kakashinho/projeto-raspberrypi/hardware/etiquetas_A_B_folha_cheia.pdf

TRIG=G23 ECHO=G24 | R=G4 G=G17 B=G27

## 3V3 DAT GND

GND
| D1 RGB

BUZZER G6

J5 DHT11 G22 | SERVO1 | SERVO2
EXT 5V | RPi | R | + | G | B

VCC

TRIG

C1 100n 3 | 2 | 1 | BTN · J8 botão G5 G12 | G25 | C2 470µ 25V | G13 | G26 R5 330 | R6 1k R2 10k | R1 10k | R4 330 | R3 330

centro

Livres p/ comunicação: I2C 2,3 · UART 14,15 · SPI0 7,8,9,10,11
SPI1/I2S 16,18,19,20,21 · ID 0,1 (reservado, não usar) | centro
J4 HC-SR04 GND− J7 +5V | JP1 | 40

39

2

1 5V 3V3

5V2 GND

3

14 15 GND

18 GND

3V3 GND

10 9

8

11

# 7GND

1

0 GND GND 16

19

20 21

4 | 17 27 | GND

23

22

### 24 RASPBERRY PI (J1): números = GPIO BCM · negrito = usado nesta placa 25

5

12

6 13 | 26 SW1
5V | nc | Q1
C | B | E

ECHO

GND

Q1 BC337

S+

−

S+

−

RV1 10k | Placa de interface Raspberry Pi · etiqueta A (em cima) + B (embaixo)

B (base) - CORTE na linha tracejada e descarte esta parte.

Cole com a linha cortada encostada na etiqueta A e a outra borda na borda de baixo da placa. TRIG=G23 ECHO=G24 | R=G4 G=G17 B=G27

## 3V3 DAT GND

GND
D1 RGB

BUZZER G6

J5 DHT11 G22 | SERVO1 | SERVO2
EXT 5V | RPi | R | + | G | B

VCC

TRIG

C1 100n 3 | 2 | 1 | BTN · J8 botão G5 G12 | G25 | C2 470µ 25V | G13 | G26 R5 330 | R6 1k R2 10k | R1 10k | R4 330 | R3 330

centro

Livres p/ comunicação: I2C 2,3 · UART 14,15 · SPI0 7,8,9,10,11
SPI1/I2S 16,18,19,20,21 · ID 0,1 (reservado, não usar) | centro
J4 HC-SR04 GND− J7 +5V | JP1 | 40

39

2

1 5V 3V3

5V2 GND

3

14 15 GND

18 GND

3V3 GND

10 9

8

11

# 7GND

1

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

5

12

6 13 | 26 SW1
5V | nc | Q1
C | B | E

ECHO

GND

Q1 BC337

S+

−

S+

−

RV1 10k | Placa de interface Raspberry Pi · etiqueta A (em cima) + B (embaixo)

B (base) - CORTE na linha tracejada e descarte esta parte.

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
