kakashinho/projeto-raspberrypi/maquete/impressao/etiquetas_pimaco6282.pdf

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
A1 | A2 | A3 | A4
ENTRADA | T1 | SAÍDA | T2
1 | 2 | 3 | 4 | 5 | 6 | 7

N1 a N7: números das vagas (pretos, colam no asfalto em frente de cada vaga)

listras da cancela: ● = eixo do servo

listras da cancela: ● = eixo do servo

res.

res.

res.

res.

res.

PIMACO 6282 (folha CARTA): imprimir a 100 %. Faixas brancas: corte pelas linhas finas. Códigos = gabarito do piso.
