kakashinho/projeto-raspberrypi/maquete/impressao/gabaritos_A4.pdf

Maquete do estacionamento: gabaritos de corte | folha 1/8

Feitos para TESOURA. Papelão de 2,5 mm, escala 1:1, versão v5

## Legenda

linha de corte: o contorno da peça

recorte (sempre aberto numa borda e largo para a tesoura): corte e tire

linha de acesso: corte reto por ela, da borda até o furo (só no piso)

dobradiça: junte as 2 peças nesta quina com fita crepe (por fora e por dentro)

tira colada: guia ou trava (use a peça vizinha como espaçador)

só no piso: corte do EVA preto

referência: onde vai cada etiqueta PIMACO, parede ou peça

Como usar
1. Imprima TODAS as folhas a 100 % (tamanho real). Em cada folha, meça a régua de 100 mm.
2. Recorte o gabarito com uma sobra, prenda no papelão com fita crepe e corte por cima com a tesoura, seguindo a linha. Ou fure os cantos com um alfinete, tire o papel e ligue os pontos a lápis.
3. Não há rasgos estreitos: todo recorte começa numa borda e tem pelo menos 10 mm de largura.
Recorte largo: corte os 2 lados até o fundo e depois o fundo.
4. Peça com ×N: use o mesmo gabarito N vezes. Tiras de 5 mm: corte uma tira comprida e depois os pedaços.
5. Dobradiças: encoste as 2 peças na quina e passe fita crepe por fora e por dentro. Elas dobram planas.
6. Tiras coladas (guias e travas): cole com cola branca encostando na peça vizinha, que serve de espaçador.

## Teste antes (corte num retalho)

11,0 | 11,5 | 12,0

servo: o corpo deve entrar justo (padrão 11,5)

9,0 | 10,0 | 11,0

tubinho do pot (Ø 8,5): padrão 10

Folhas
2 e 3: piso (2 metades, emendar pelas cruzes) ꞏ 4: paredes da guarita ꞏ 5: telhado e laterais da moldura 6: frente/fundo e meio da moldura, guia da calçada ꞏ 7: carro, totem, braço, botão, batente e tiras
8: plano de corte da chapa. Etiquetas: etiquetas_pimaco6282.pdf (CARTA). Adesivos: adesivos_A4.pdf Material extra: fita crepe (dobradiças) e cola branca (tiras, EVA e carros).
0 | 50 | 100

100 mm: confira com uma régua

IMPRIMIR EM TAMANHO REAL (100 %), sem ajustar à página

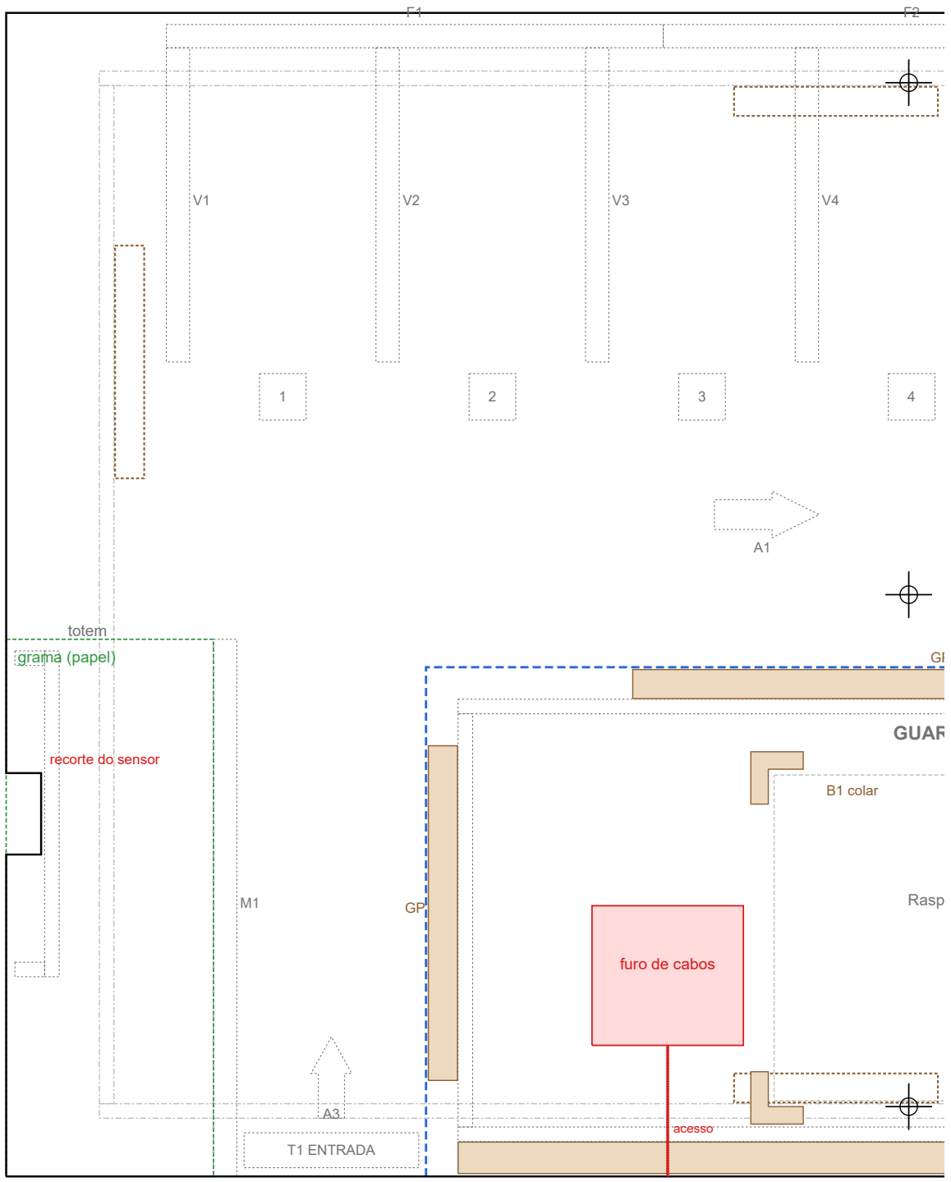
[picture p60: figure]
Raspberry Pi (entre os batentes); GUARITA: chão sem EVA; totem; grama (papel); B1 colar; GP colar (guia do fundo); T1 ENTRADA; furo de cabos; acesso; recorte do sensor

FRENTE (lado de quem opera a maquete) ↓

P1 Piso: metade esquerda | folha 2/8

Vista de cima, frente embaixo. Sobreponha as 2 folhas pelas 3 cruzes e prenda com fita.

Piso (papelão 311 × 200): sem rasgos
- Contorno: o retângulo já desenhado (281 × 200) cresce 30 mm para a direita. Recorte do sensor: aberto na borda.
- Furos (vermelho): corte reto pela linha de acesso (tracejada), da borda da frente até o furo, e recorte o furo. Depois passe fita crepe por baixo da linha de acesso. A tira da calçada, colada por cima, também fecha o corte.
- EVA preto: mesmo molde. Contorno, recorte da guarita (azul) e recorte do sensor. Cole com cola branca.
- Tiras: GP e B1 colam em cima; TP (tracejado marrom) colam por baixo. Etiquetas: códigos em cinza.

P1 Piso: metade direita | folha 3/8

Vista de cima, frente embaixo. Sobreponha as 2 folhas pelas 3 cruzes e prenda com fita.

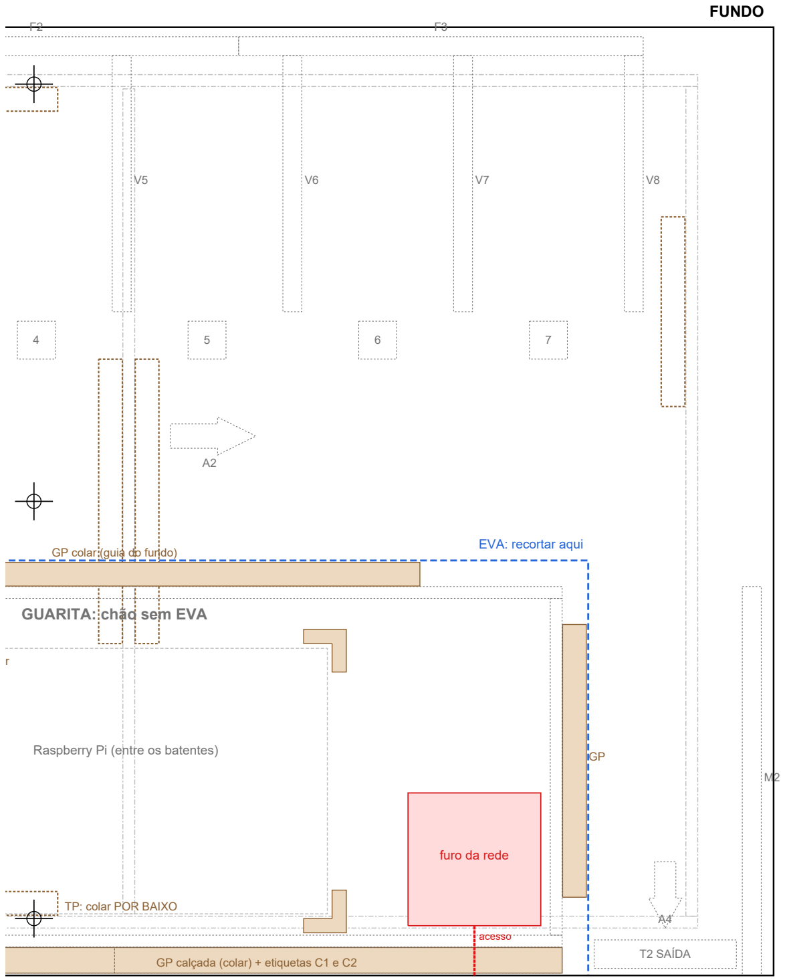
[picture p61: figure]
TP: colar POR BAIXO; Raspberry Pi (entre os batentes); GUARITA: chão sem EVA; B1 colar; GP colar (guia do fundo); T2 SAÍDA; GP calçada (colar) + etiquetas C1 e C2; EVA: recortar aqui; furo da rede; acesso; FUNDO

Piso (papelão 311 × 200): sem rasgos
- Contorno: o retângulo já desenhado (281 × 200) cresce 30 mm para a direita. Recorte do sensor: aberto na borda.
- Furos (vermelho): corte reto pela linha de acesso (tracejada), da borda da frente até o furo, e recorte o furo. Depois passe fita crepe por baixo da linha de acesso. A tira da calçada, colada por cima, também fecha o corte.
- EVA preto: mesmo molde. Contorno, recorte da guarita (azul) e recorte do sensor. Cole com cola branca.
- Tiras: GP e B1 colam em cima; TP (tracejado marrom) colam por baixo. Etiquetas: códigos em cinza.

Guarita: paredes | folha 4/8

Fundo + 2 laterais com dobradiças de fita (dobram planas). O painel fica solto.

## G1 Painel (parede da frente) ×1

vista de FORA (você de frente para o painel) ↑ em cima

tubinho

LED

energia

fita | fita

## G2 Parede do fundo ×1

recortes de baixo: servos (em pé, eixo para fora) dobradiças (verde) nas 2 pontas, com as laterais G3 ↑ em cima

fita

### G3 Parede lateral ×2

↑ em cima
← frente | fundo (fita) →

Montagem da guarita
1. Junte G2 com as 2 G3 pelas quinas de trás (fita crepe por fora e por dentro): vira um U.
2. Ponha os servos em pé no piso, no lugar; desça o U por cima: os servos entram pelos recortes de baixo do fundo.
3. O U fica entre as guias GP coladas no piso.
4. Pi + placa entre os batentes.
5. Painel G1: atrás da tira da calçada, encostado na frente das laterais. O botão do pot, por fora, segura ele em pé.
6. Telhado por cima (travas GT por dentro). Para tirar o painel: puxe o botão, incline para a frente e levante.

Telhado e laterais da moldura | folha 5/8

Telhado visto de cima (frente embaixo); as travas GT colam por baixo.

## G4 Telhado ×1

vista de cima, FRENTE embaixo ↓ tracejado marrom: travas GT (colar POR BAIXO)

Telhado
Retângulo liso. As 3 travas GT colam embaixo, por dentro das laterais e do fundo:
o telhado encaixa no U e não escorrega. O painel da frente sai sem tirar o telhado.

Moldura (estrutura de 5 cm) 4 painéis com dobradiças nos cantos (o 4º canto fecha com fita na montagem). Os vãos embaixo são para os cabos.

fita | fita

## ES Moldura: lateral ×2

↑ em cima (encosta no piso)
o vão é a passagem do cabo do sensor

Moldura: frente/fundo e painel do meio | folha 6/8

A frente e o fundo são iguais (×2). O painel do meio fica solto, entre 2 travas TP coladas embaixo do piso.

fita | fita

## EF Moldura: frente e fundo ×2

↑ em cima
o vão é a passagem do cabo de rede

## EM Moldura: painel do meio ×1

↑ em cima
solto; fica de pé entre as travas TP do meio

Montagem da moldura
1. Junte EF, ES, EF, ES com fita nas quinas (por fora e por dentro), formando um anel.
2. Feche a última quina com um pedaço de fita.
3. Ponha o painel do meio EM em pé.
4. Desça o piso: as travas TP de baixo encaixam por dentro da moldura e dos dois lados do EM.
Para guardar: tire a fita da última quina e dobre a moldura em ziguezague.

GP guia da calçada ×1 (188,8 × 5,4): cola na frente da guarita, encostada no painel; as etiquetas C1 e C2 vão em cima

Peças pequenas e tiras | folha 7/8

Carro (caixinha colada), totem do sensor, braço da cancela, botão do pot, batente do Pi e as tiras de 5 mm.

CL ×16
Carro: lateral
2 por carro

CF ×16
Carro: frente/traseira
2 por carro | CT ×8
| Carro: teto
| 1 por carro

S1 ×1
Totem: frente
↑ em cima
janelas = sensor

S2 ×2
Totem: lado
fita na quina
com S1

C1 ×2
Braço da cancela
- = eixo do servo | K1 ×1
| Botão do pot

B1 ×4
Batente do Pi
colar no piso

### Tiras de 5 mm (cola branca)

GP ×1 guia do fundo (128,8 × 5,0)

GP ×2 guia lateral (57,5 × 5,0)

GT ×1 trava do fundo (143,8 × 5,0)

GT ×2 trava lateral (51,0 × 5,0)

TP ×2 trava do meio (60,0 × 5,0)

TP ×2 trava lateral (40,0 × 5,0)

TP ×2 trava frente/fundo (35,0 × 5,0)

Carro (8): caixinha colada
1. Cole os adesivos nas peças.
2. Teto CT virado para baixo; cole as
2 laterais CL em pé nas bordas compridas e a frente/traseira CF entre elas.
Totem: S1 + 2 S2 com fita nas quinas;
o sensor fica dentro, pinos no recorte.

Plano de corte da chapa de papelão (1 m × 1 m), escala 1:6 | folha 8/8

Sugestão de onde tirar cada peça. Deixe ~4 mm entre as peças.

P1

G4 | G2 | G3 | G3
G1 | EF | EF | ES
ES | EM
S1 | CT

CT

CT | CT | CT | CT | CT | CT | CL | CL | CL | CL | CL | CL
CL | CL | CL | CL | CL | CL | CL | CL | CL | CL

## Lista de peças de papelão

Código Peça | Qtd | Medida
P1 | Piso | ×1 | 311,0 × 200,0 mm
EF | Moldura: frente e fundo | ×2 | 279,0 × 47,5 mm
ES | Moldura: lateral | ×2 | 175,0 × 47,5 mm
EM | Moldura: painel do meio | ×1 | 174,0 × 47,5 mm
G1 | Painel (parede da frente) | ×1 | 188,8 × 61,5 mm
G2 | Parede do fundo | ×1 | 188,8 × 62,0 mm
G3 | Parede lateral | ×2 | 71,0 × 62,0 mm
G4 | Telhado | ×1 | 194,8 × 82,0 mm
S1 | Totem: frente | ×1 | 56,0 × 26,0 mm
S2 | Totem: lado | ×2 | 5,1 × 26,0 mm
C1 | Braço da cancela | ×2 | 55,1 × 8,0 mm
K1 | Botão do pot | ×1 | 16,0 × 16,0 mm
B1 | Batente do Pi | ×4 | 9,0 × 9,0 mm
CL | Carro: lateral | ×16 | 50,0 × 15,0 mm
CF | Carro: frente/traseira | ×16 | 19,0 × 15,0 mm
CT | Carro: teto | ×8 | 24,0 × 50,0 mm
+ tiras de 5 mm: GP ×4, TP ×6, GT ×3 (comprimentos nas folhas 6 e 7)
