kakashinho/projeto-raspberrypi/codigo/exemplos_originais/LEIA-ME.md

# Exemplos originais

Os 9 scripts do começo do projeto, sem alterações. Só `rgb_pwm_interativo.py` e `calibracao_pot2.py` estão de acordo com a placa final. Os outros usam pinos da montagem antiga ou têm TRIG e ECHO trocados. A tabela de ajustes está no guia, seção "Códigos de teste (antigo)".
