kakashinho/projeto-raspberrypi/hardware/previas/etiqueta_A_pimaco.png

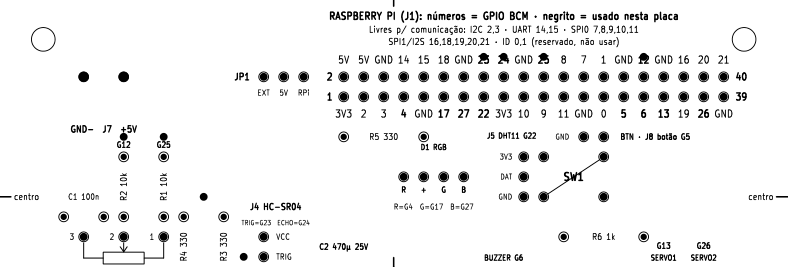
hardware/previas/etiqueta_A_pimaco.png
