kakashinho/projeto-raspberrypi/hardware/previas/placa_topo_adesivo.png

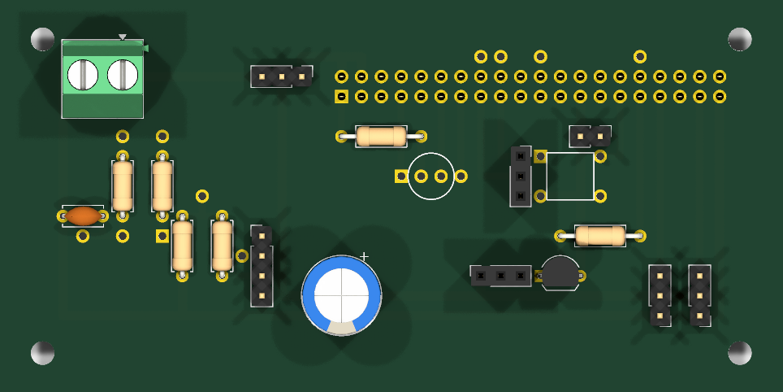
hardware/previas/placa_topo_adesivo.png
