kakashinho/projeto-raspberrypi/hardware/previas/previa_etiqueta.png

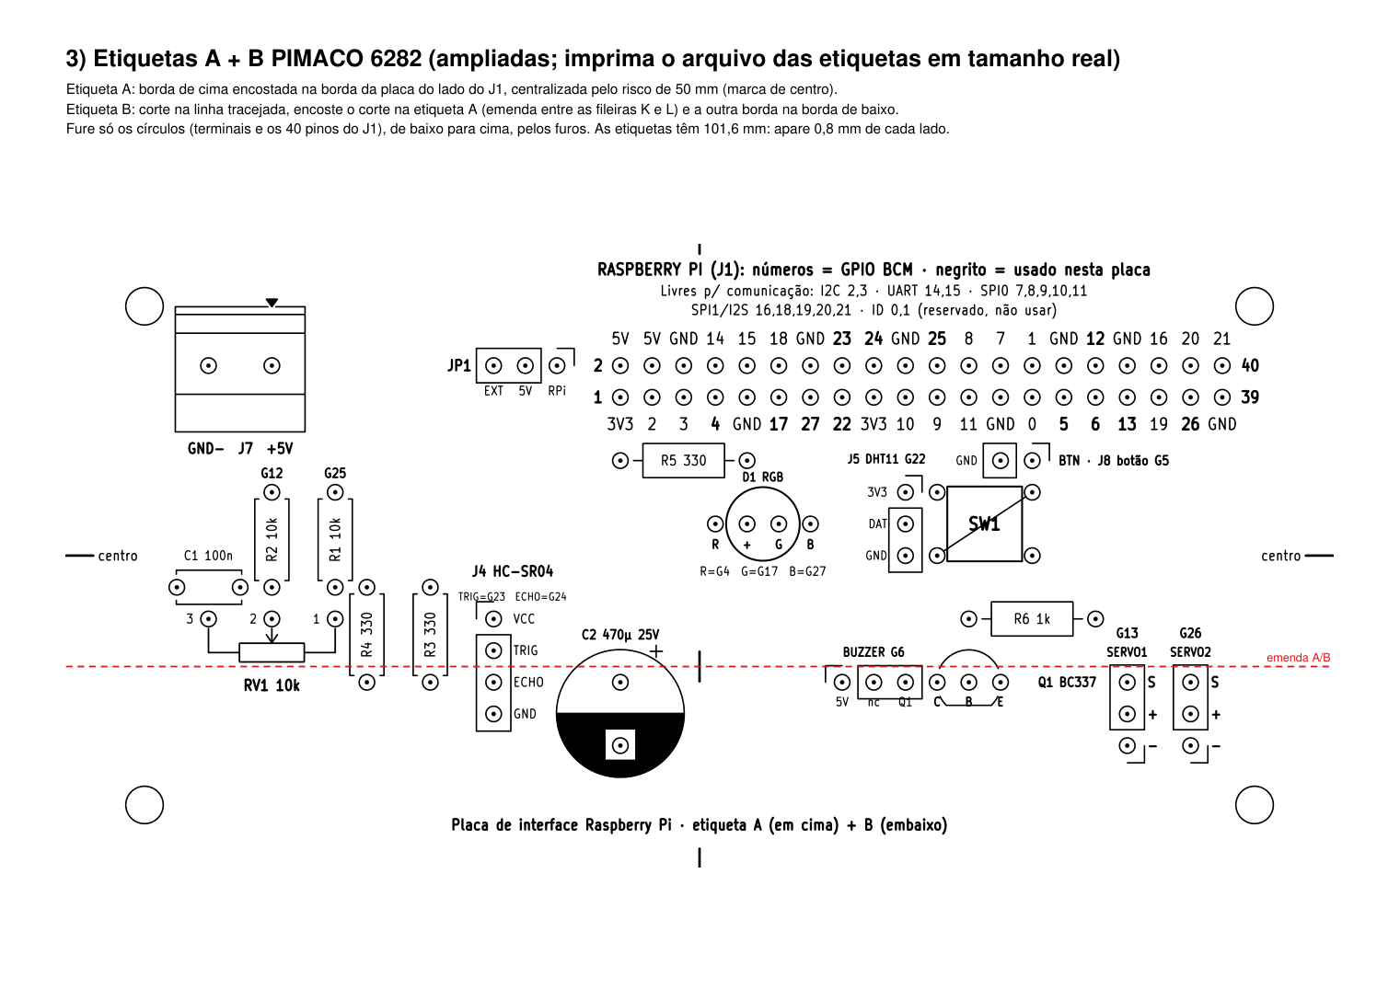
hardware/previas/previa_etiqueta.png
