kakashinho/projeto-raspberrypi/hardware/previas/previa_folha.png

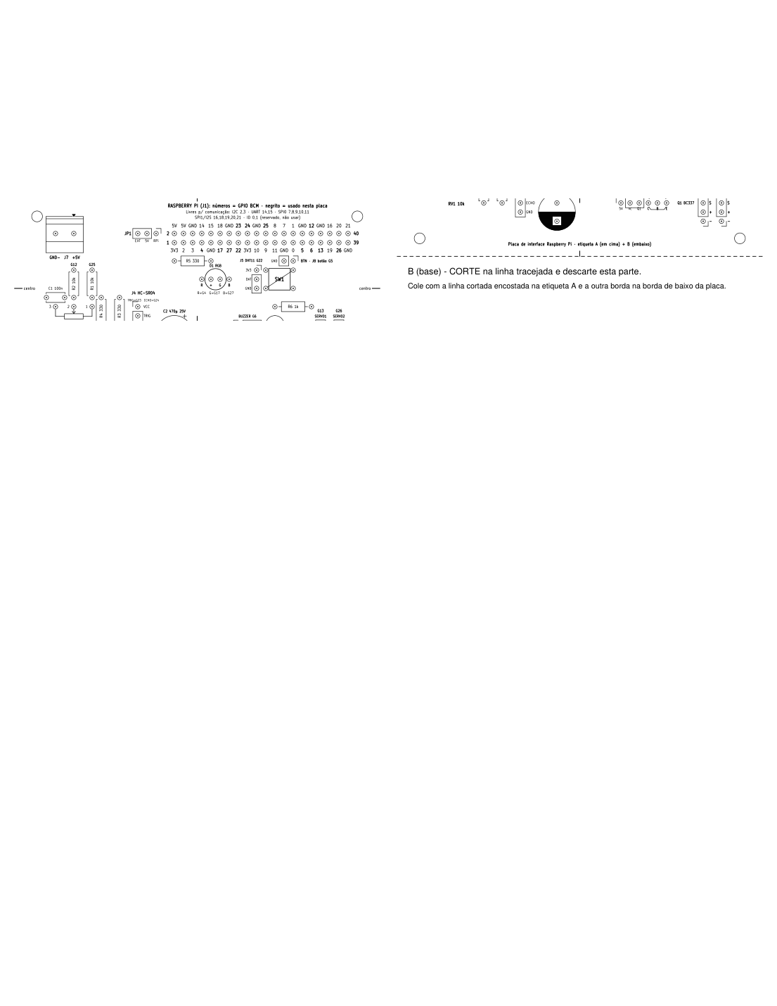
hardware/previas/previa_folha.png
