kakashinho/projeto-raspberrypi/hardware/previas/previa_lista.png

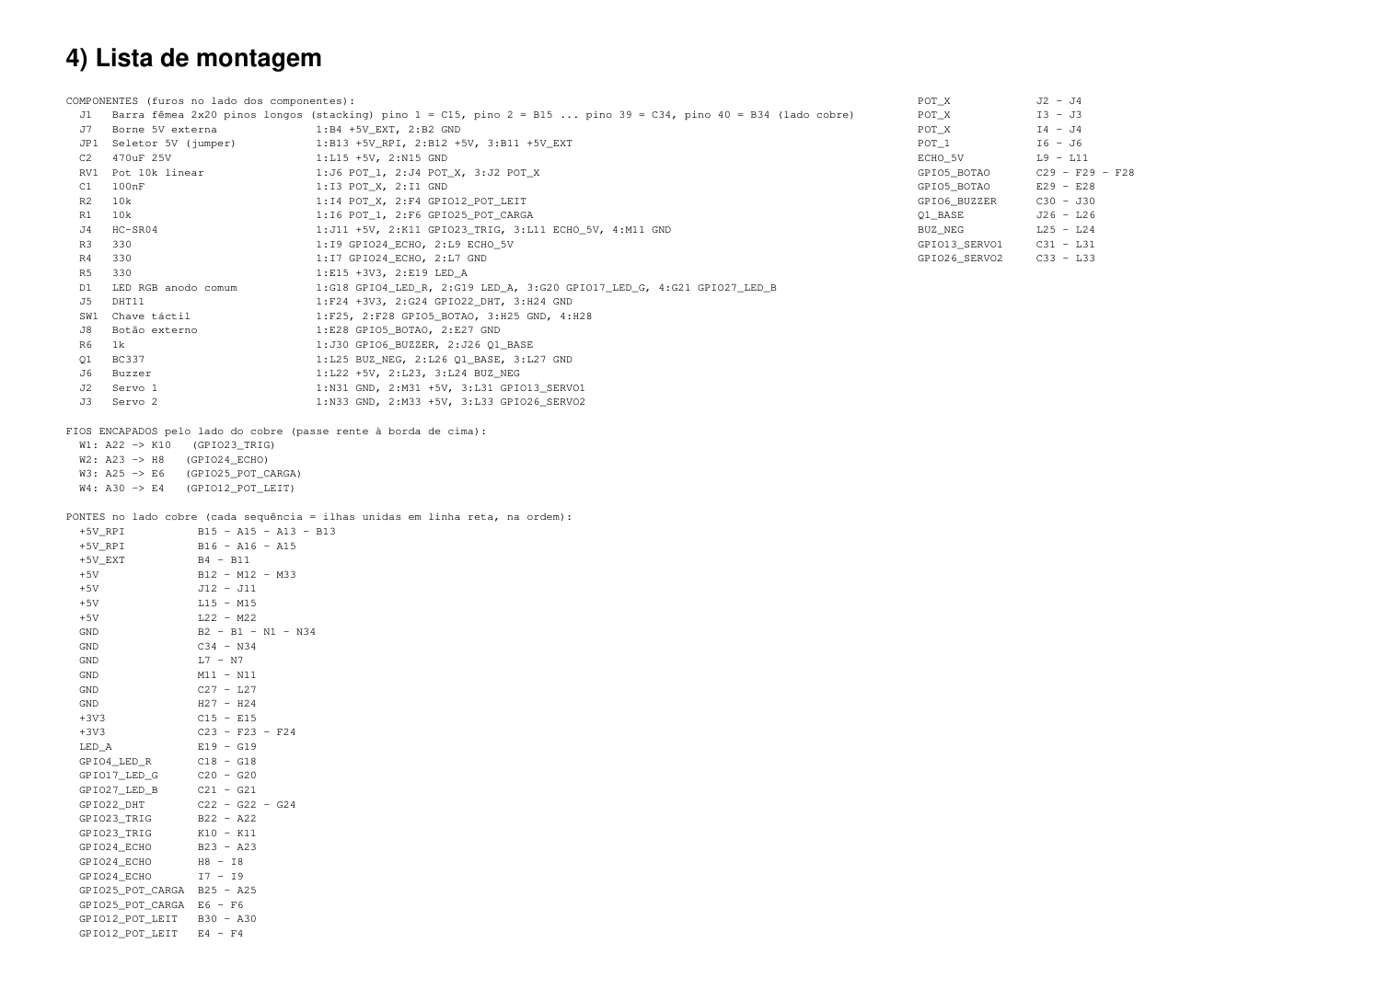
hardware/previas/previa_lista.png
