kakashinho/projeto-raspberrypi/hardware/previas/previa_trilhas.png

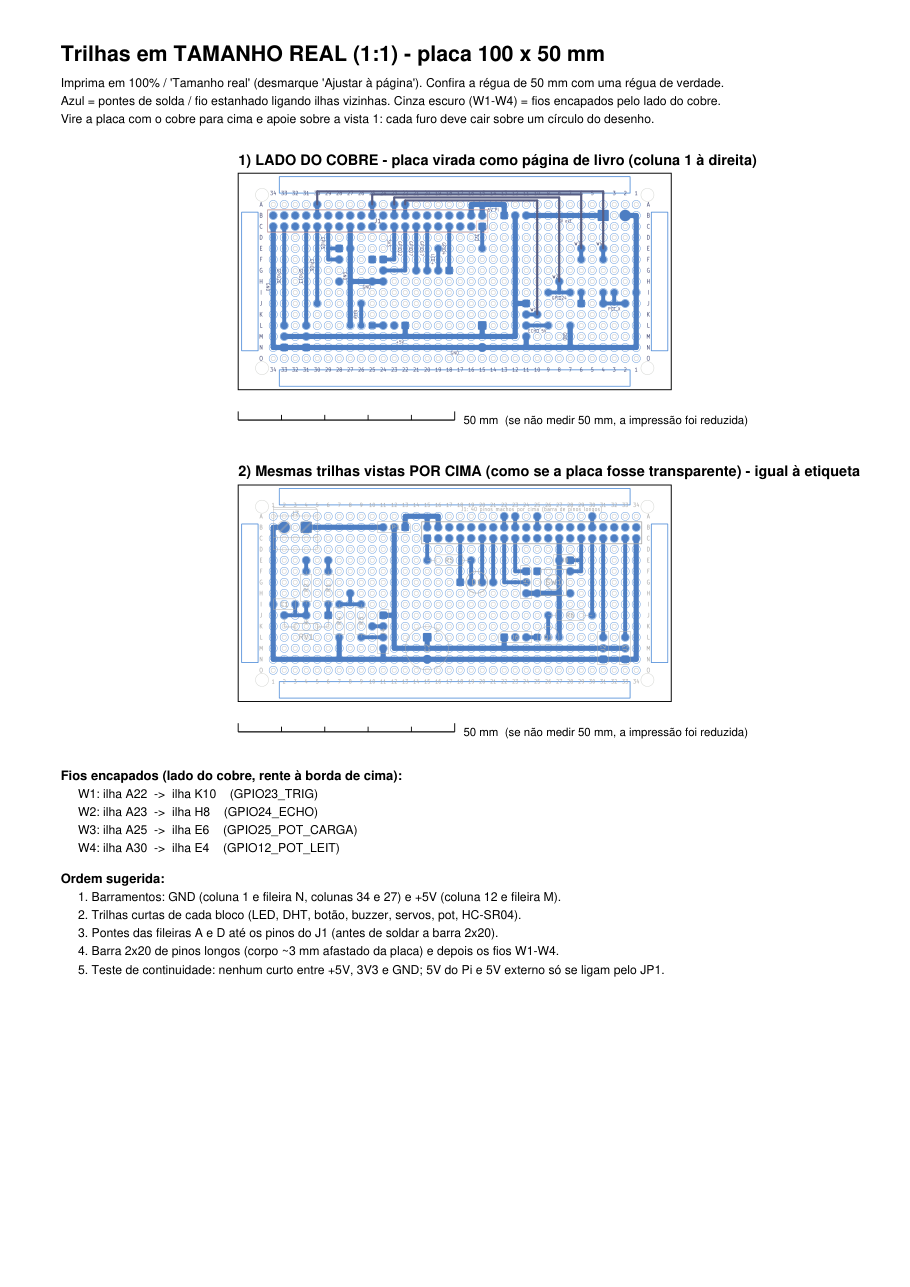
hardware/previas/previa_trilhas.png
