kakashinho/projeto-raspberrypi/maquete/previas/planta_v5.png

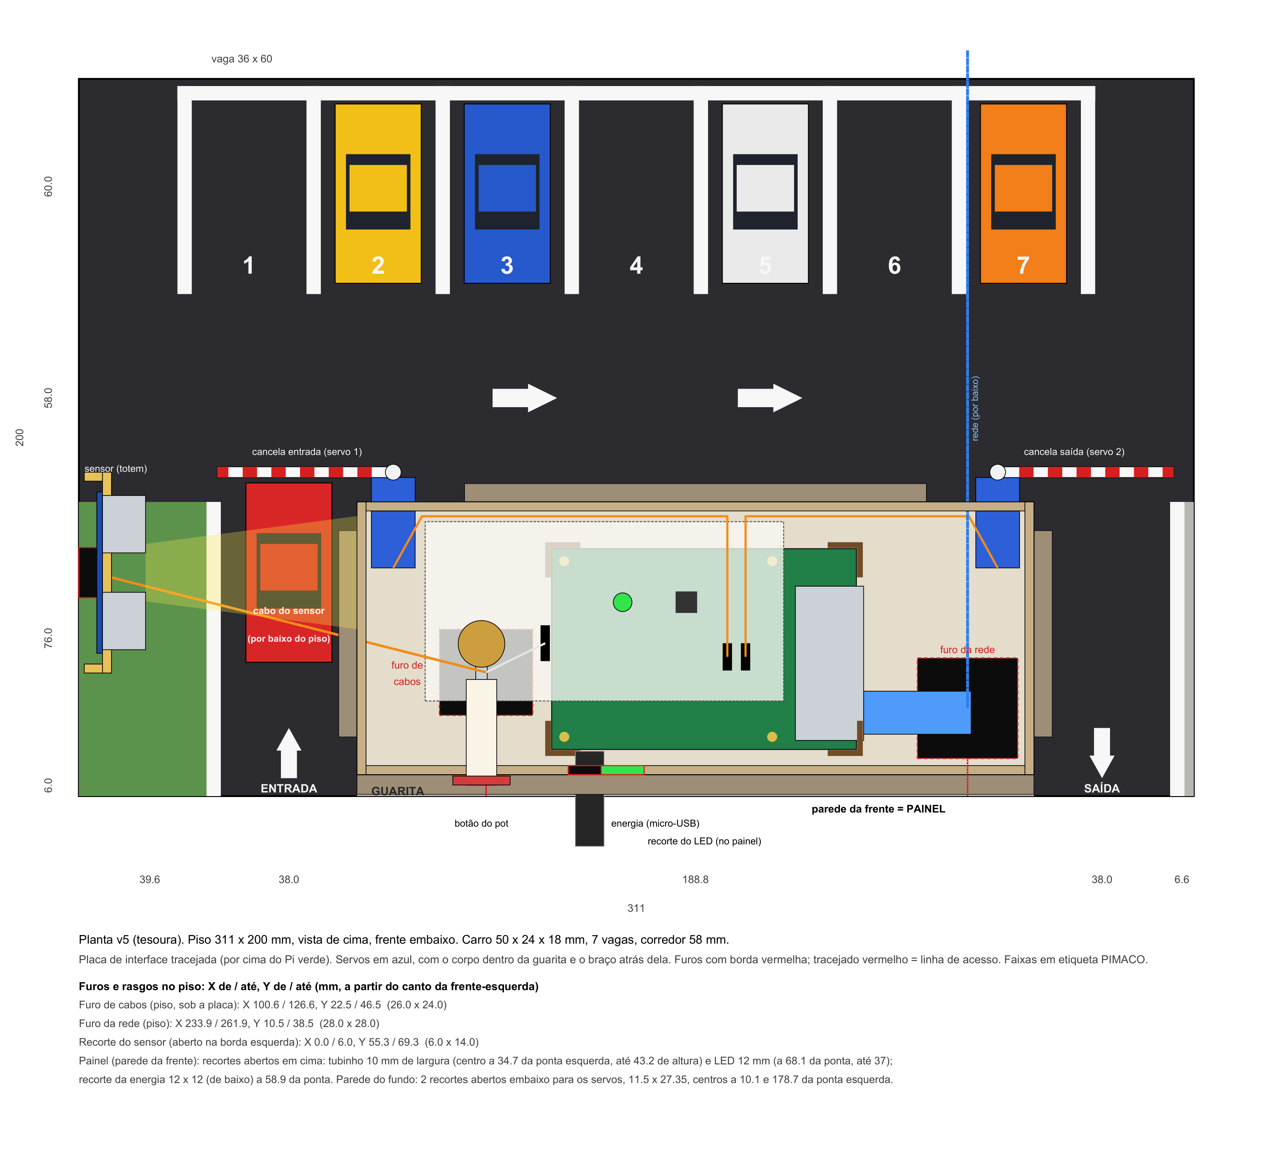
maquete/previas/planta_v5.png
