kakashinho/projeto-raspberrypi/hardware/previas/previa_montagem_p1.png

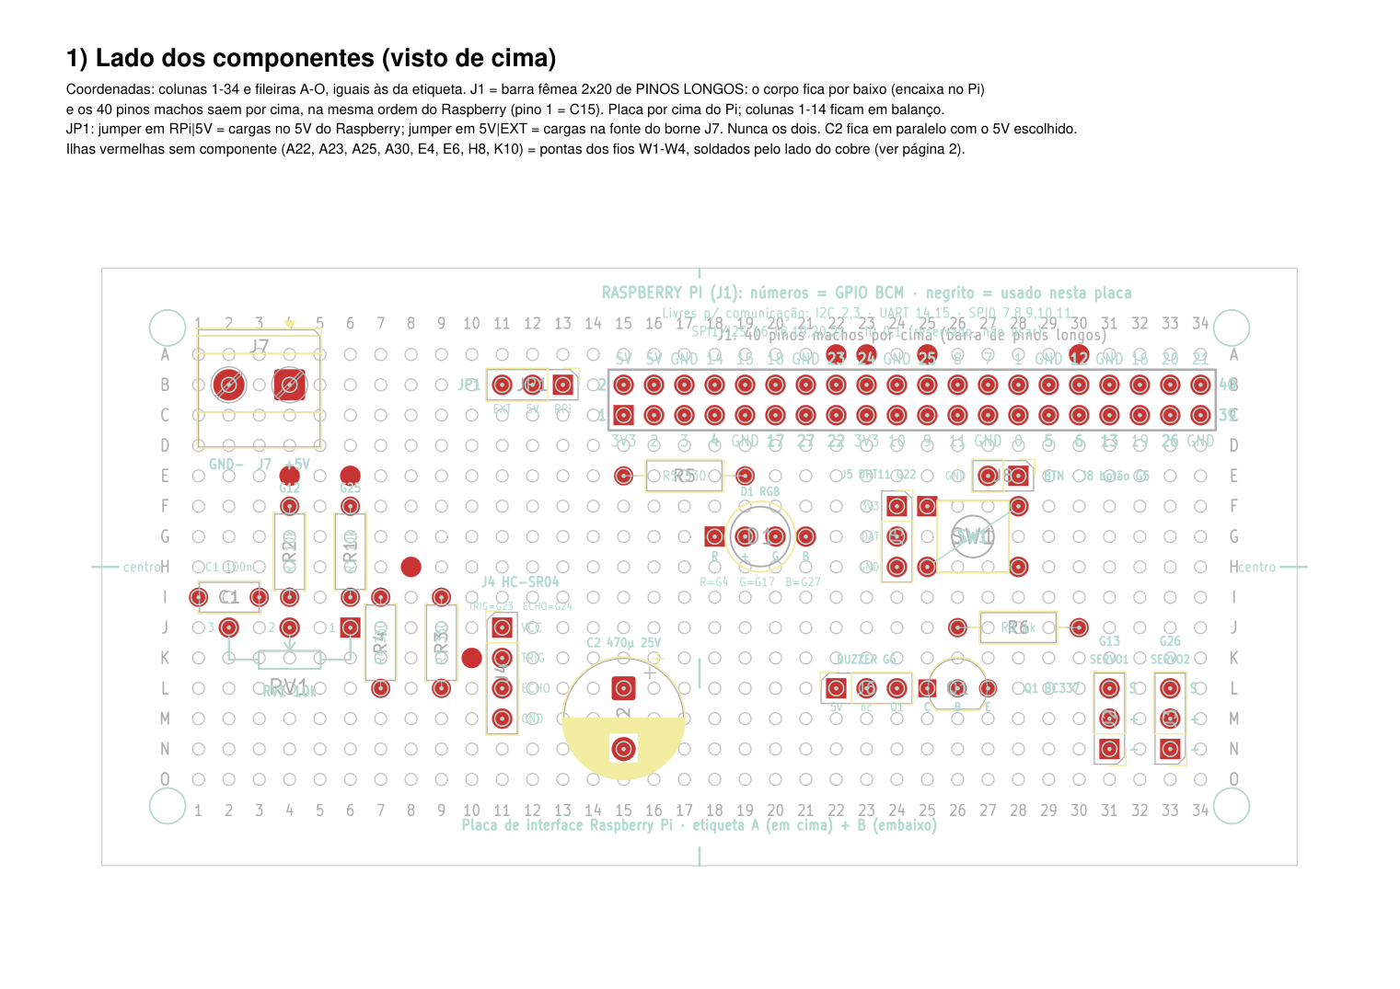
hardware/previas/previa_montagem_p1.png
