kakashinho/projeto-raspberrypi/hardware/previas/previa_montagem_p2.png

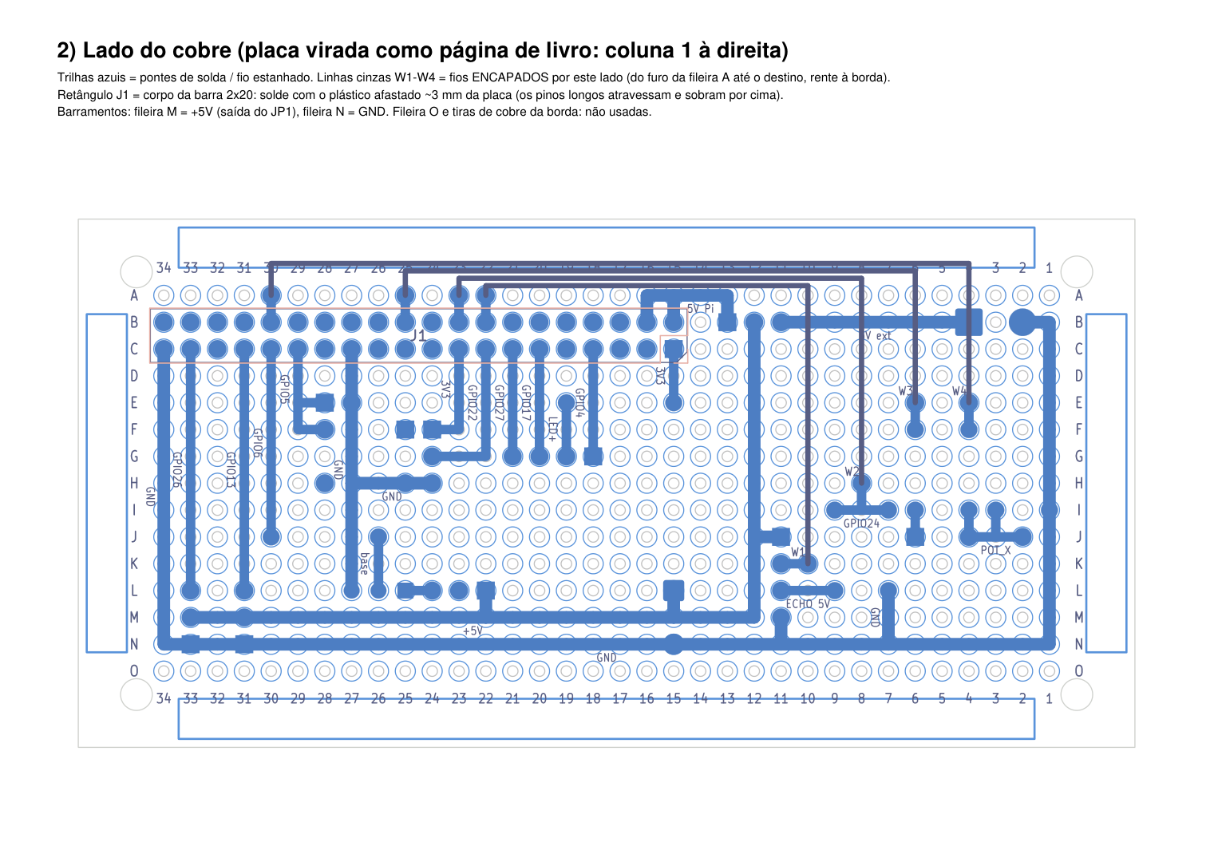
hardware/previas/previa_montagem_p2.png
