kakashinho/projeto-raspberrypi/maquete/impressao/etiquetas_pimaco6282_teste.pdf

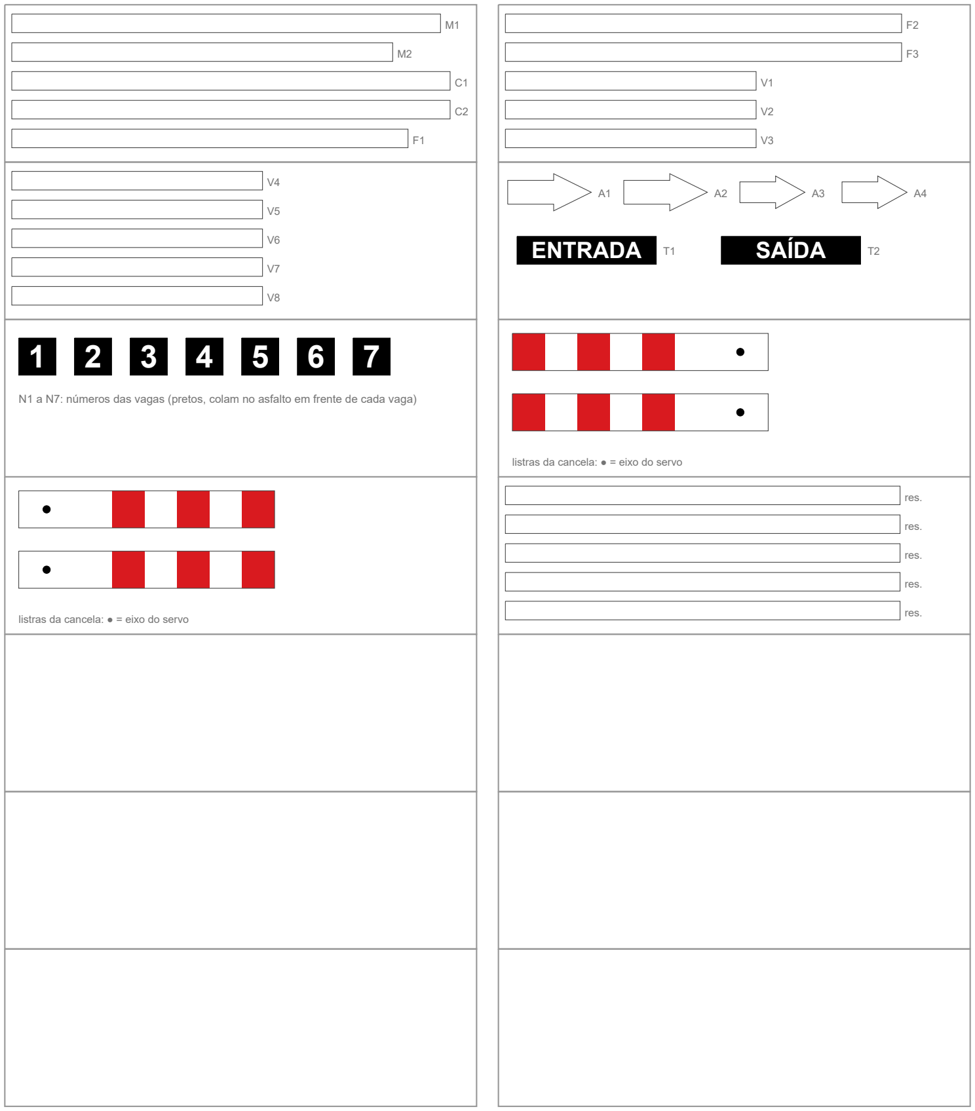
[picture p73: figure]
ENTRADA; SAÍDA; listras da cancela: ● = eixo do servo; res.

N1 a N7: números das vagas (pretos, colam no asfalto em frente de cada vaga)

TESTE em papel comum: imprima a 100 % (papel CARTA), ponha sobre a folha PIMACO 6282 contra a luz e confira.
