kakashinho/projeto-raspberrypi/hardware/etiquetas_teste_papel_comum.pdf

1 5V 3V3

# 7GND

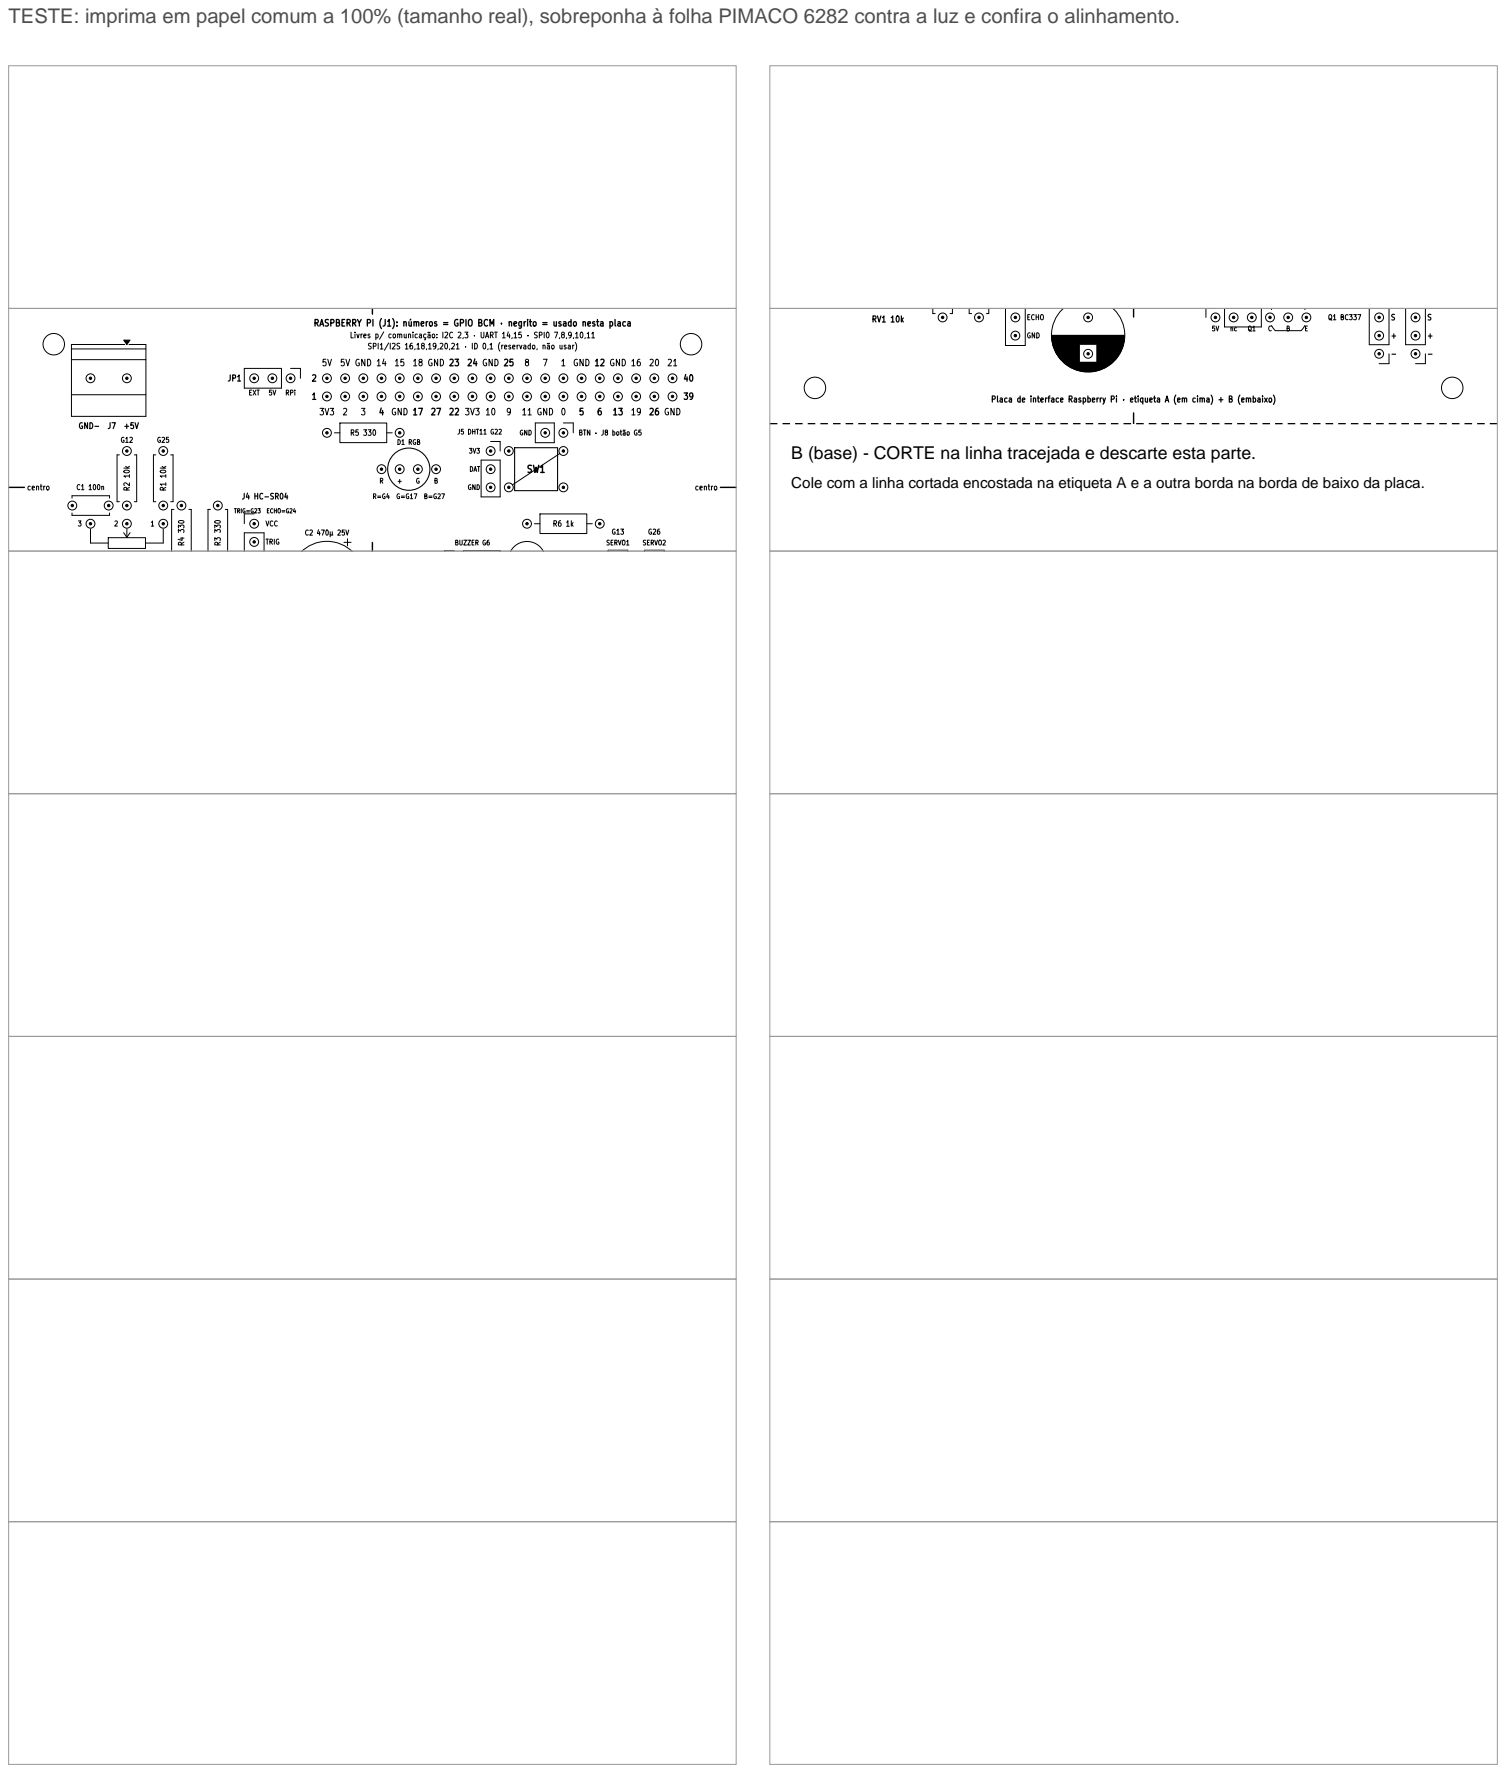
[picture p74: page 1]

TESTE: imprima em papel comum a 100% (tamanho real), sobreponha à folha PIMACO 6282 contra a luz e confira o alinhamento.

24 RASPBERRY PI (J1): números = GPIO BCM · negrito = usado nesta placa 25

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
