kakashinho/projeto-raspberrypi/maquete/impressao/adesivos_A4.pdf

Adesivos da guarita | adesivos 1/3

Imprima colorido, recorte pela linha fina e cole com cola bastão. Tracejado vermelho = recortar fora.

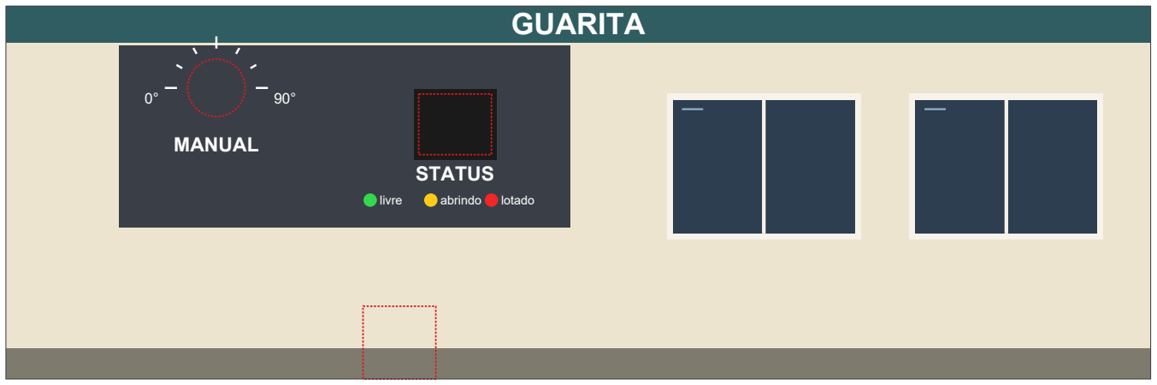
[picture p75: figure]
GUARITA; MANUAL; STATUS; livre; abrindo; lotado

### G1 painel: cole na face de FORA. O papel cobre os recortes de cima; recorte o círculo e a

janela do LED (dobre o papel no meio deles e corte) e o recorte de baixo.

# ESTACIONAMENTO

G2 fundo: cole na face de FORA (lado das cancelas); corte os 2 recortes de baixo (servos).

G3 lateral (porta) | G3 lateral (janela)

# SENSOR

### S1 totem: faixa de cima (acima das janelas)

| K1 botão
0 | 50 | 100

## 100 mm: confira com uma régua

## IMPRIMIR EM TAMANHO REAL (100 %), sem ajustar à página

Adesivos: telhado e grama | adesivos 2/3

Telhado e grama vistos de cima, com a frente embaixo.

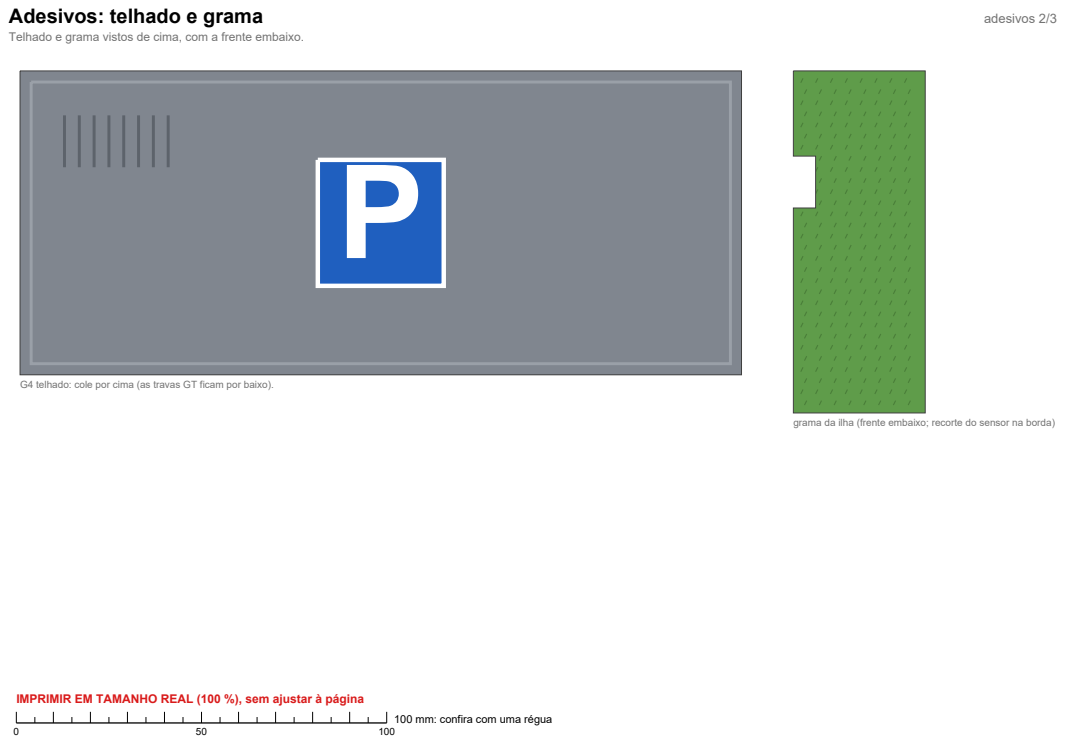
[picture p76: page 2]

G4 telhado: cole por cima (as travas GT ficam por baixo).

grama da ilha (frente embaixo; recorte do sensor na borda)

Adesivos dos carros (8) | adesivos 3/3

Teto, 2 laterais, frente e traseira de cada carro. Cole com cola bastão em cada peça ANTES de montar.

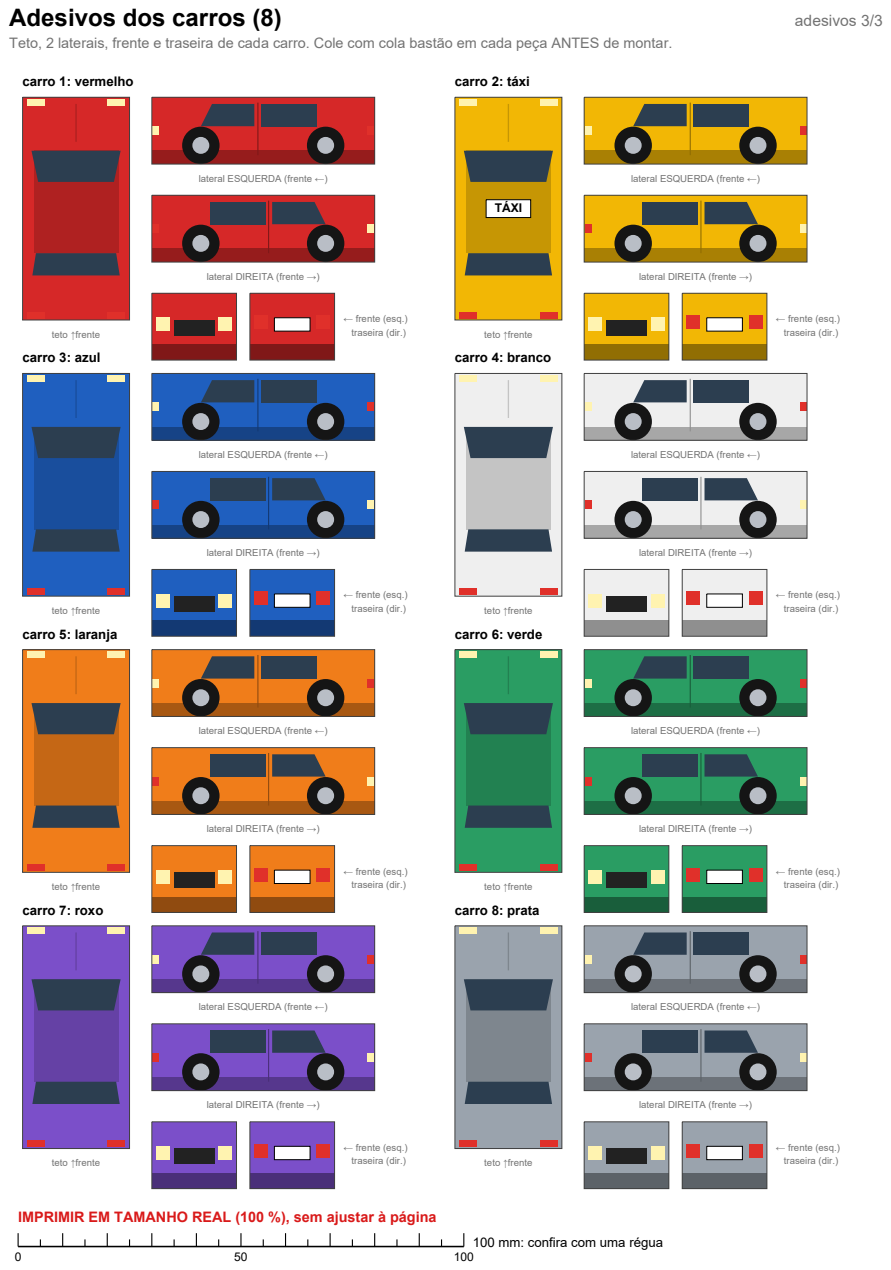
[picture p77: page 3]
carro 1: vermelho; teto ↑frente; ← frente (esq.) traseira (dir.); carro 2: táxi; TÁXI; carro 3: azul; carro 4: branco; carro 5: laranja; carro 6: verde; carro 7: roxo; carro 8: prata

lateral ESQUERDA (frente ←)

lateral DIREITA (frente →)
