kakashinho/projeto-raspberrypi/hardware/placa_interface.kicad_pcb

## KiCad design hardware/placa_interface.kicad_pcb (2026-11-08)

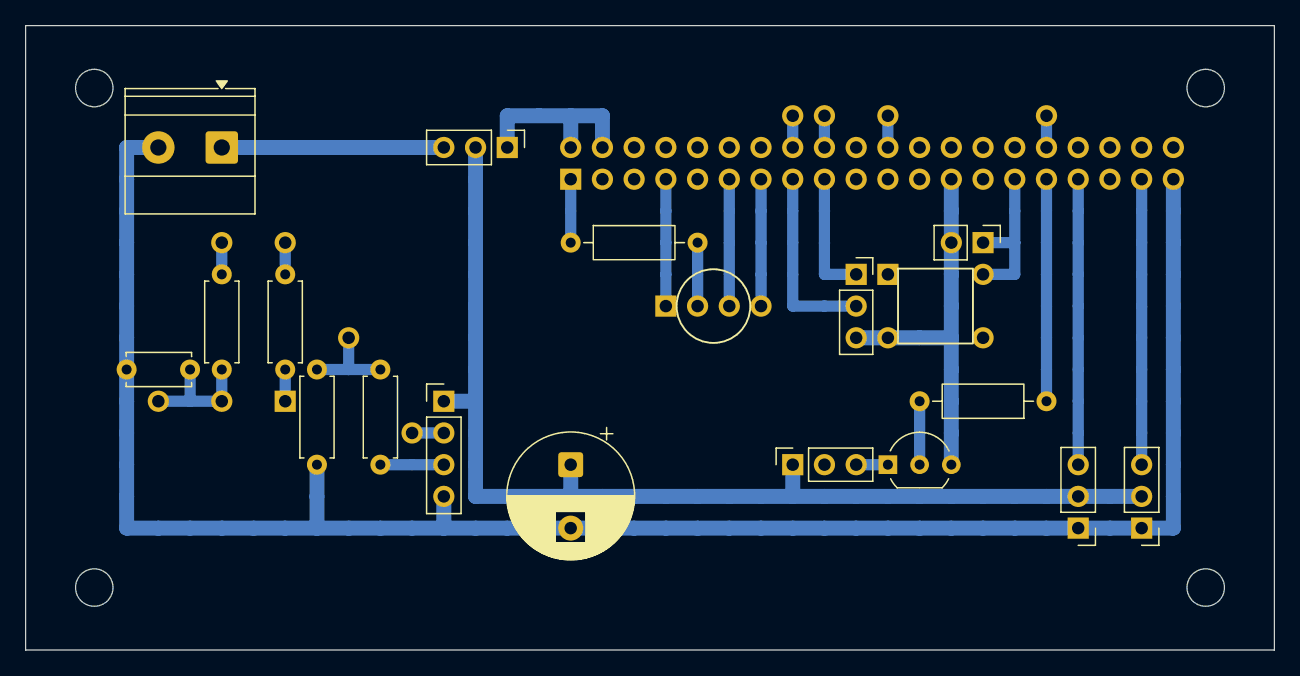
[picture p78: board placa_interface.kicad_pcb from above]

Board: 2 copper layers, 100.0 x 50.0 mm, 25 parts (1 on the bottom side), 23 nets.

Parts:
C1: 100nF; C_Disc_D5.0mm_W2.5mm_P5.00mm
C2: 470uF 25V; CP_Radial_D10.0mm_P5.00mm
D1: LED RGB anodo comum
J1: Barra fêmea 2x20 pinos longos (stacking); PinSocket_2x20_P2.54mm_Vertical
J2: Servo 1; PinHeader_1x03_P2.54mm_Vertical
J3: Servo 2; PinHeader_1x03_P2.54mm_Vertical
J4: HC-SR04; PinHeader_1x04_P2.54mm_Vertical
J5: DHT11; PinSocket_1x03_P2.54mm_Vertical
J6: Buzzer; PinSocket_1x03_P2.54mm_Vertical
J7: Borne 5V externa; TerminalBlock_Phoenix_MKDS-1,5-2-5.08_1x02_P5.08mm_Horizont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
J8: Botão externo; PinHeader_1x02_P2.54mm_Vertical
JP1: Seletor 5V (jumper); PinHeader_1x03_P2.54mm_Vertical
Q1: BC337; TO-92_Inline_Wide
R1, R2: 10k; R_Axial_DIN0207_L6.3mm_D2.5mm_P7.62mm_Horizontal
R3, R4: 330; R_Axial_DIN0207_L6.3mm_D2.5mm_P7.62mm_Horizontal
R5: 330; R_Axial_DIN0207_L6.3mm_D2.5mm_P10.16mm_Horizontal
R6: 1k; R_Axial_DIN0207_L6.3mm_D2.5mm_P10.16mm_Horizontal
RV1: Pot 10k linear
SW1: Chave táctil
W1, W2, W3, W4: fio encapado (lado cobre)

Connections:
+3V3: J1.1, J1.17, J5.1, R5.1
+5V: C2.1, J2.2, J3.2, J4.1, J6.1, JP1.2
+5V_EXT: J7.1, JP1.3
+5V_RPI: J1.2, J1.4, JP1.1
BUZ_NEG: J6.3, Q1.1
ECHO_5V: J4.3, R3.2
GND: C1.2, C2.2, J1.6, J1.9, J1.14, J1.20, J1.25, J1.30, J1.34, J1.39, J2.1, J3.1, J4.4, J5.3, J7.2, J8.2, Q1.3, R4.2, SW1.3
GPIO4_LED_R: D1.1, J1.7
GPIO5_BOTAO: J1.29, J8.1, SW1.2
GPIO6_BUZZER: J1.31, R6.1
GPIO12_POT_LEIT: J1.32, R2.2, W4.1
GPIO13_SERVO1: J1.33, J2.3
GPIO17_LED_G: D1.3, J1.11
GPIO22_DHT: J1.15, J5.2
GPIO23_TRIG: J1.16, J4.2, W1.1
GPIO24_ECHO: J1.18, R3.1, R4.1, W2.1
GPIO25_POT_CARGA: J1.22, R1.2, W3.1
GPIO26_SERVO2: J1.37, J3.3
GPIO27_LED_B: D1.4, J1.13
LED_A: D1.2, R5.2
POT_1: R1.1, RV1.1
POT_X: C1.1, R2.1, RV1.2, RV1.3
Q1_BASE: Q1.2, R6.2
