kakashinho/projeto-raspberrypi/codigo/sistema/pinos.py

SERVO_ENTRADA = 13
SERVO_SAIDA = 26

US_TRIG = 23
US_ECHO = 24

LED_R, LED_G, LED_B = 4, 17, 27

BUZZER = 6
BOTAO = 5

POT_CARGA = 12
POT_LE = 25

DHT11 = 22
