kakashinho/projeto-raspberrypi/codigo/starter/tarefa5_teste_dht11.py

import time
import board
import adafruit_dht

dht = adafruit_dht.DHT11(board.D22)    # GPIO22

while True:
    try:
        print(f"{dht.temperature} °C | {dht.humidity} %")
    except RuntimeError as erro:        # leituras falhas são normais no DHT11
        print("tentando de novo:", erro.args[0])
    time.sleep(2)
