kakashinho/projeto-raspberrypi/(commit log)

2026-11-08 chore: ignora logs e arquivos de execução
2026-11-08 docs: lista de materiais, netlist e guia de transferência
    [ligacoes_netlist.csv, lista_de_materiais.csv]
2026-11-08 feat(hardware): projeto da placa de interface e gerador
    [placa_interface.kicad_pcb]
2026-11-08 feat(maquete): maquete de papelão e EVA com gerador
2026-11-08 feat(starter): códigos de partida das 8 tarefas
2026-11-08 feat(sistema): módulos de hardware
2026-11-08 chore(sistema): scripts de execução e serviços
2026-11-08 docs: vídeo de demonstração do protótipo
2026-11-08 docs(guia): guia da equipe em PDF para impressão
2026-11-08 docs: explica onde fica a pasta do sistema no Raspberry
2026-11-08 docs: README com fluxo de desenvolvimento, ilustrações e vistas da placa
2026-11-08 docs(guia): contrato da API com batimento e códigos de resposta
    - contrato: POST /api/controlador/batimento, códigos de resposta de
    POST /api/comandos, expiração de comandos e controlador_online
    - tarefa 6: batimento, fila quando o servidor cai, cooldown e modo manual
    - tarefa 8: mensagens para 409 e 503 do botão de saída
    - PDF regenerado
